BerZerKku/BVP_XXvX/readme.txt

Плата BVP.
Сделана в OrCAD 16.6.

>>> 04v5
Предназначена для работы в аппаратах Р400/Р400м/РЗСК/К400/ОПТИКА как со старыми панелями, так и с новыми.

Изменения:
Исправлена ошибка на схеме, сделана возможность управления МКУ.
Заменен конденсатор С8 на 0,01мкФ, для устранения "хрипов" во время сигнала вызова.
Добавлена возможность установки на плату УМ SSM2305.

Код ПП: 3.140.017
Код ПП в сборе: 2.140.175

Стэк:
18мкм  TOP 
1.5мм e=4.5 FR-4
18мкм  BOTTOM

>>> 04v4
Предназначена для работы в аппаратах Р400/Р400м/РЗСК/К400/ОПТИКА как со старыми панелями, так и с новыми.

Сигналы RxBSP и TxBSP поменяны друг с другом.
На схеме найдена ошибка, сигнал управления МКУ закорочен на землю - т.е. речи нет и не будет.
Работает с платой KVP_03v3.
При работе с платой KVP_03v2 не будет работать ЦС.

>>> 04v3
Добавлена цифровая ретрансляция.
На схеме найдена ошибка, перепутаны местами сигналы RxBSP и TxBSP. 
Не использовать.
Работает с платой KVP_03v3.
При работе с платой KVP_03v2 не будет работать ЦС.

>>> 04v2 - СЕРИЯ
Входы управления подключены к 24В вместо земли.
Изменена подтяжка на +5В сигнала речи для варианта К400 (в варианте с речью, 
подтяжка идет к +5ВА).
Неиспользуемые входы микросхемы DD2 подтянуты к земле через резистор 10кОм.
Сделана возможность использования платы для Р400.
Немного передвинуты линии сигнализаций в верхней части.

>>> 04v1
Первая версия платы. 
На схеме имеются ошибки. 
Не использовать.
