BerZerKku/BVP_XXvX/(list of files, cad)

Other CAD files:
doc/Плата BVP_04v5 2.140.175 (СБ).dwg
