BerZerKku/BVP_XXvX/doc/Плата BVP_04v5 2.140.175 (СБ).pdf

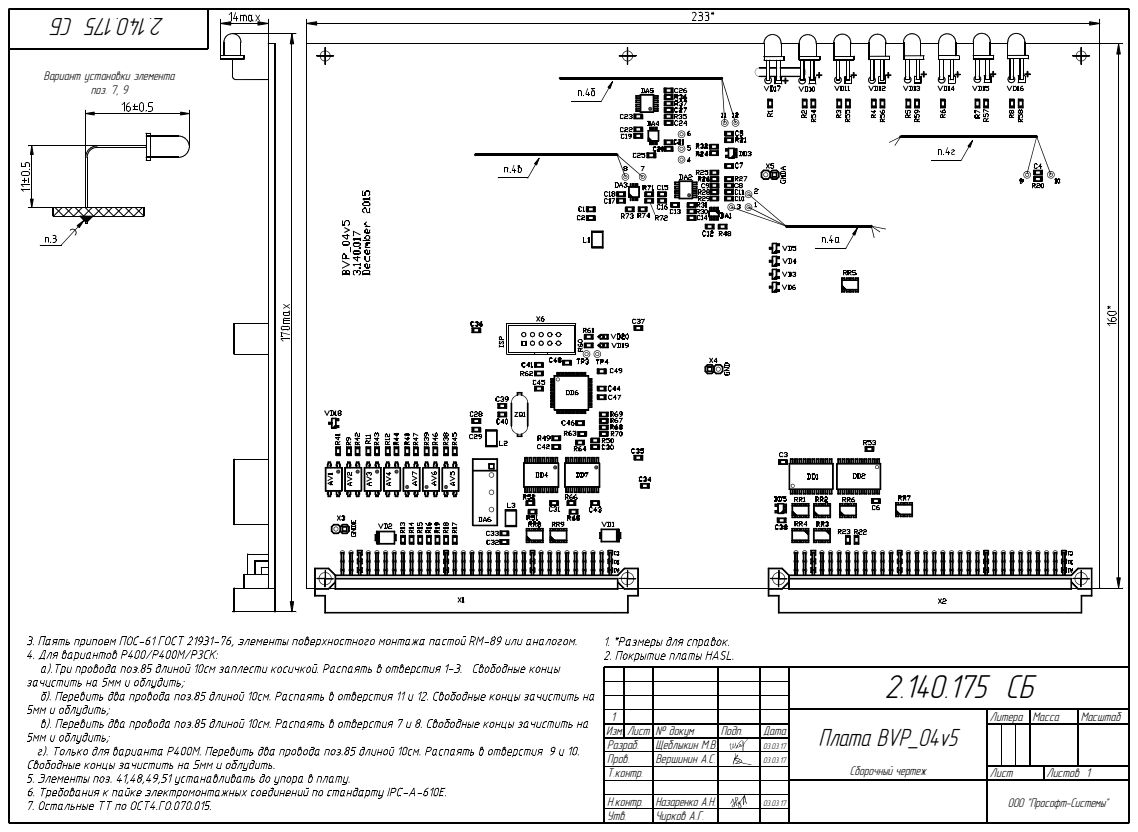
[picture p1: page 1]
Ëèñòîâ 1; Ìàññà; Ìàñøòàá; Ïîäï.; Äàòà; Óòâ.; Í.êîíòð.; Ò.êîíòð.; Ïðîâ.; Ðàçðàá.; Èçì. Ëèñò; ×èðêîâ À.Ã.; Íàçàðåíêî À.Í.; Âåðøèíèí À.Ñ.; Ùåáëûêèí Ì.Â.; № äîêóì; Ëèñò; Ëèòåðà; Ïëàòà BVP_04v5; ïîç. 7, 9

Âàðèàíò óñòàíîâêè ýëåìåíòà

Ñáîðî÷íûé ÷åðòåæ

ÎÎÎ "Ïðîñîôò-Ñèñòåìû"
