BerZerKku/BVP_XXvX/doc/Плата BVP_04v5 2.140.175 (Э3).pdf

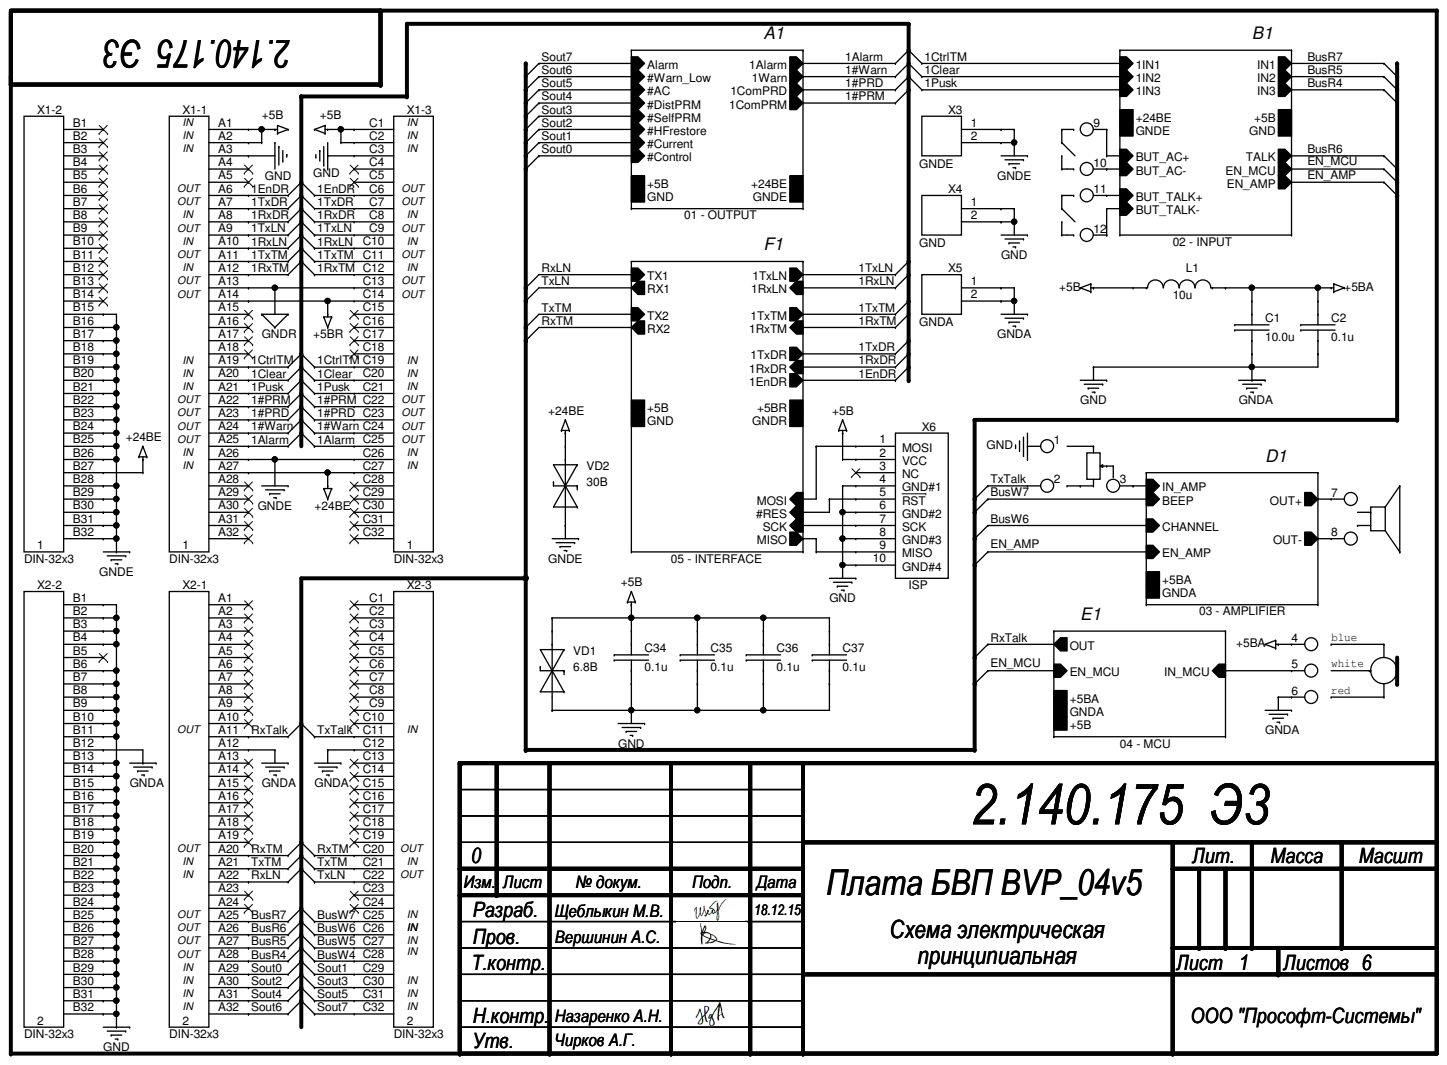
[picture p2: page 1]

0 | | | | | Плата БВП BVP_04v5 Плата БВП BVP_04v5 Плата БВП BVP_04v5 Схема электрическая Схема электрическая Схема электрическая | Лит. | Масса Масса Масса | Масшт Масшт Масшт
Изм. Изм. Изм. | Лист Лист Лист | № докум. № докум. № докум. | Подп. Подп. Подп. | Дата Дата Дата
Разраб. Разраб. Разраб. | | Щеблыкин М.В. Щеблыкин М.В. Щеблыкин М.В. | | 18.12.15 18.12.15 18.12.15
Пров. Пров. Пров. | | Вершинин А.С. Вершинин А.С. Вершинин А.С.
принципиальная Т.контр. принципиальная Т.контр. принципиальная Т.контр. | Лист Лист Лист 1 6 1 6 1 6 | Листов Листов Листов

Н.контр. Н.контр. Н.контр. | Назаренко А.Н. Назаренко А.Н. Назаренко А.Н.
Утв. Утв. Утв. | Чирков А.Г. Чирков А.Г. Чирков А.Г.

ООО "Прософт-Системы" ООО "Прософт-Системы" ООО "Прософт-Системы"

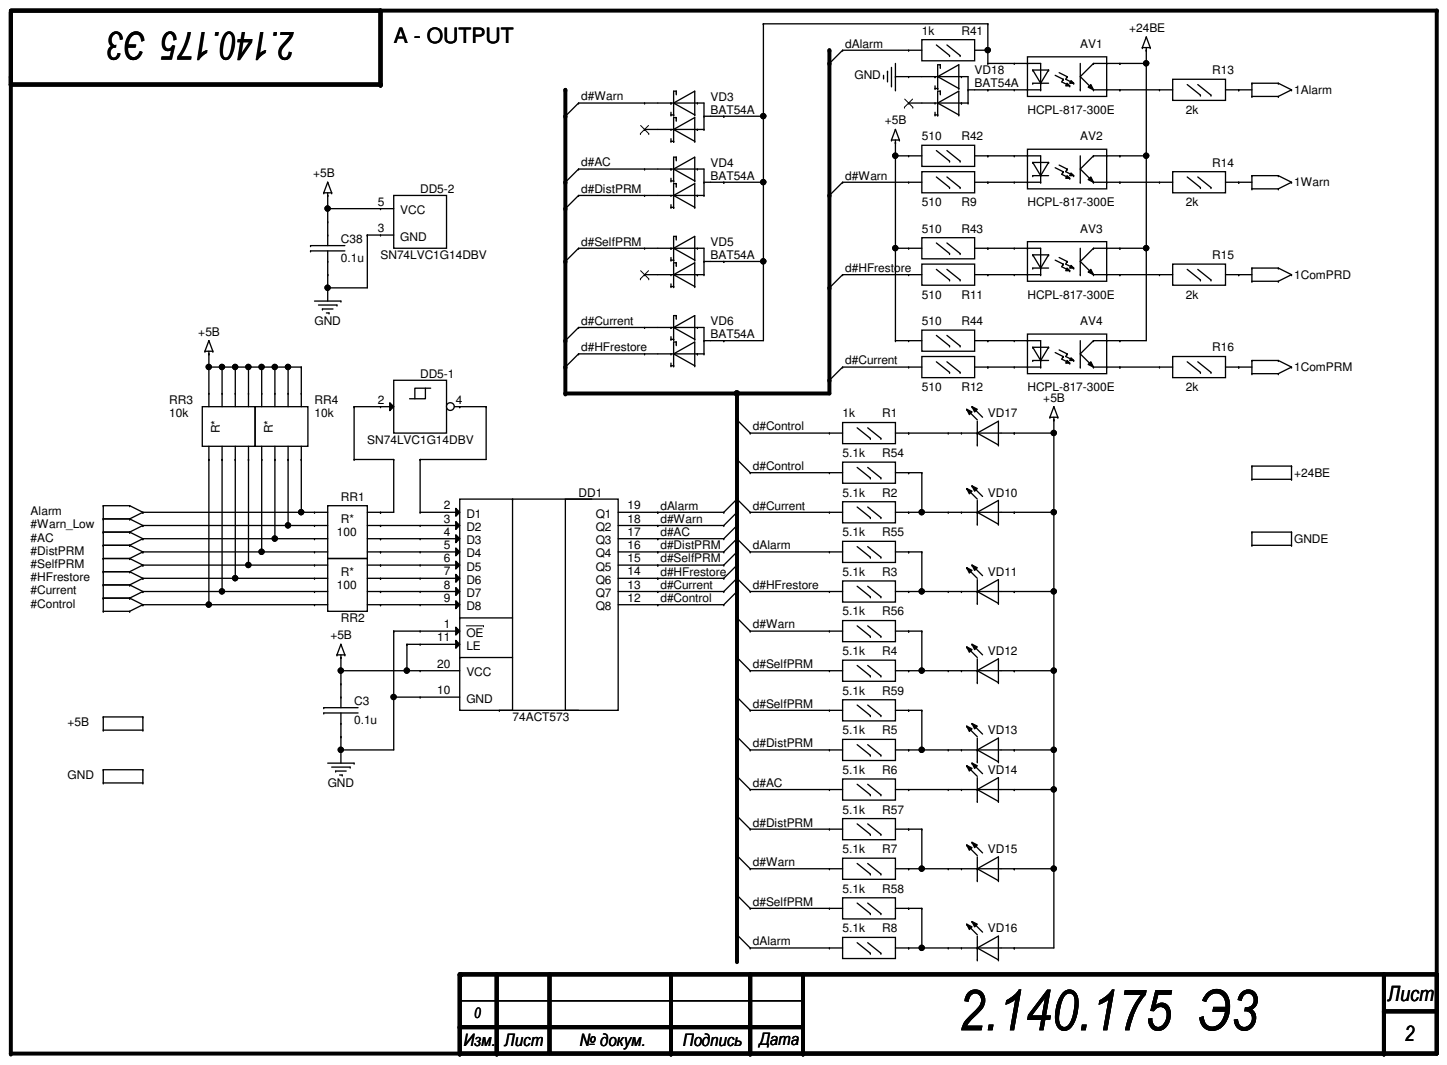
[picture p3: page 2]

Лист 2.140.175 Э3 Лист 2.140.175 Э3 Лист 2.140.175 Э3 2 ⁰ Изм. 2 ⁰ Изм. 2 ⁰

Лист | № докум. | Подпись | Дата

Изм. | Лист | № докум. | Подпись | Дата

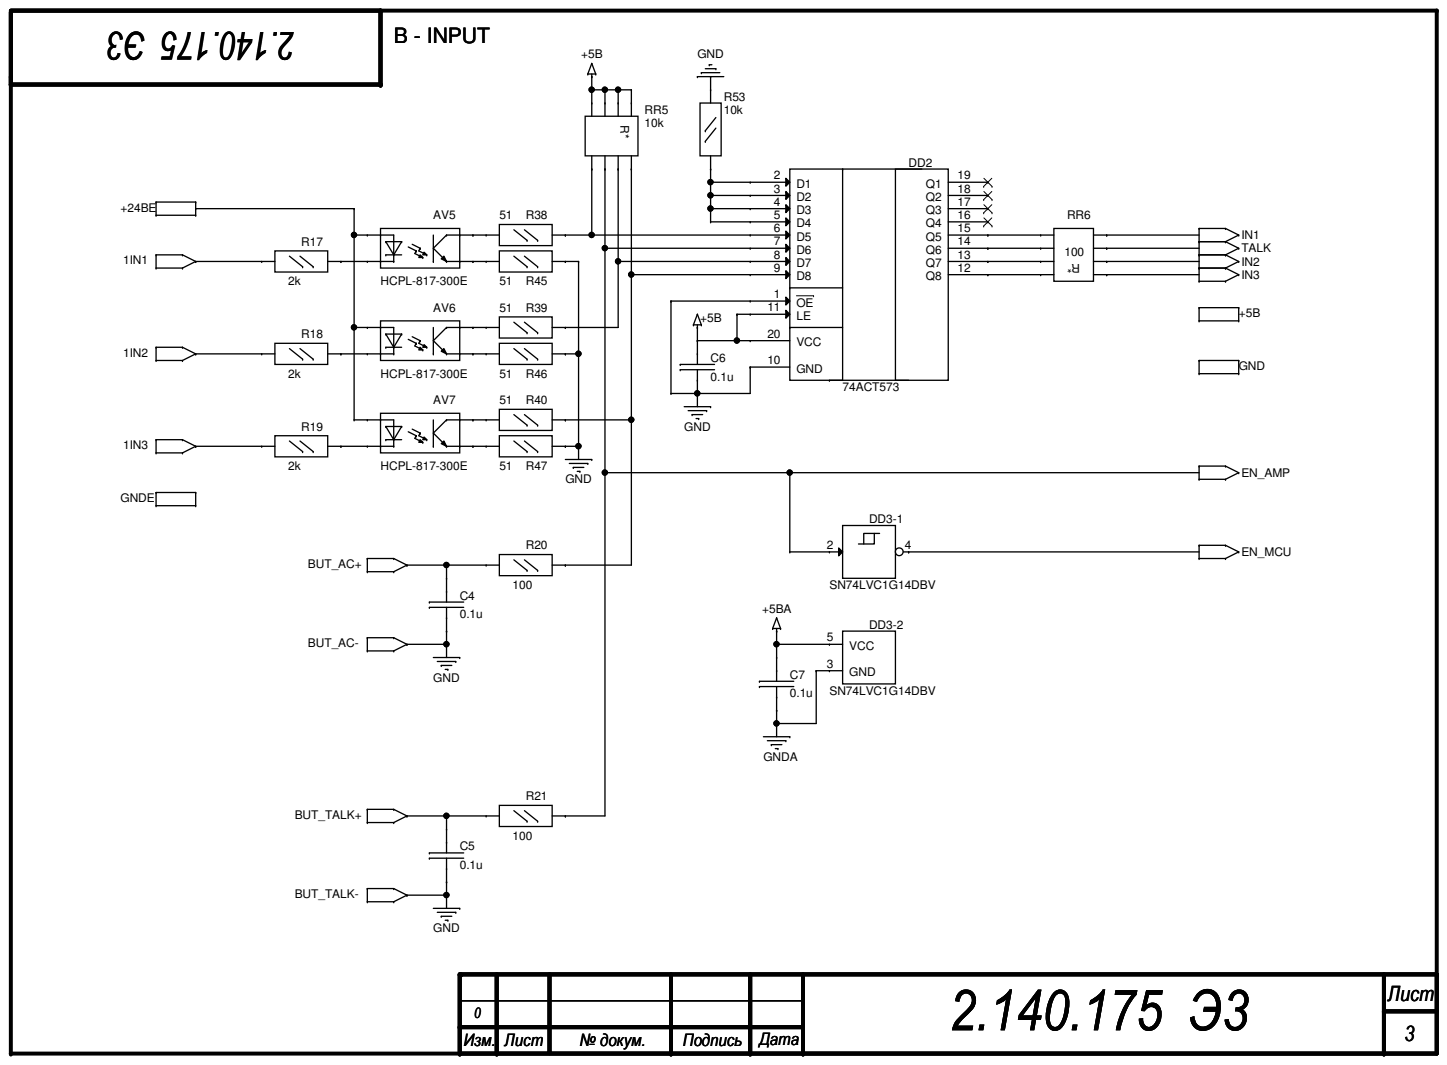
[picture p4: page 3]

Лист 2.140.175 Э3 Лист 2.140.175 Э3 Лист 2.140.175 Э3 3 ⁰ Изм. 3 ⁰ Изм. 3 ⁰

Лист | № докум. | Подпись | Дата

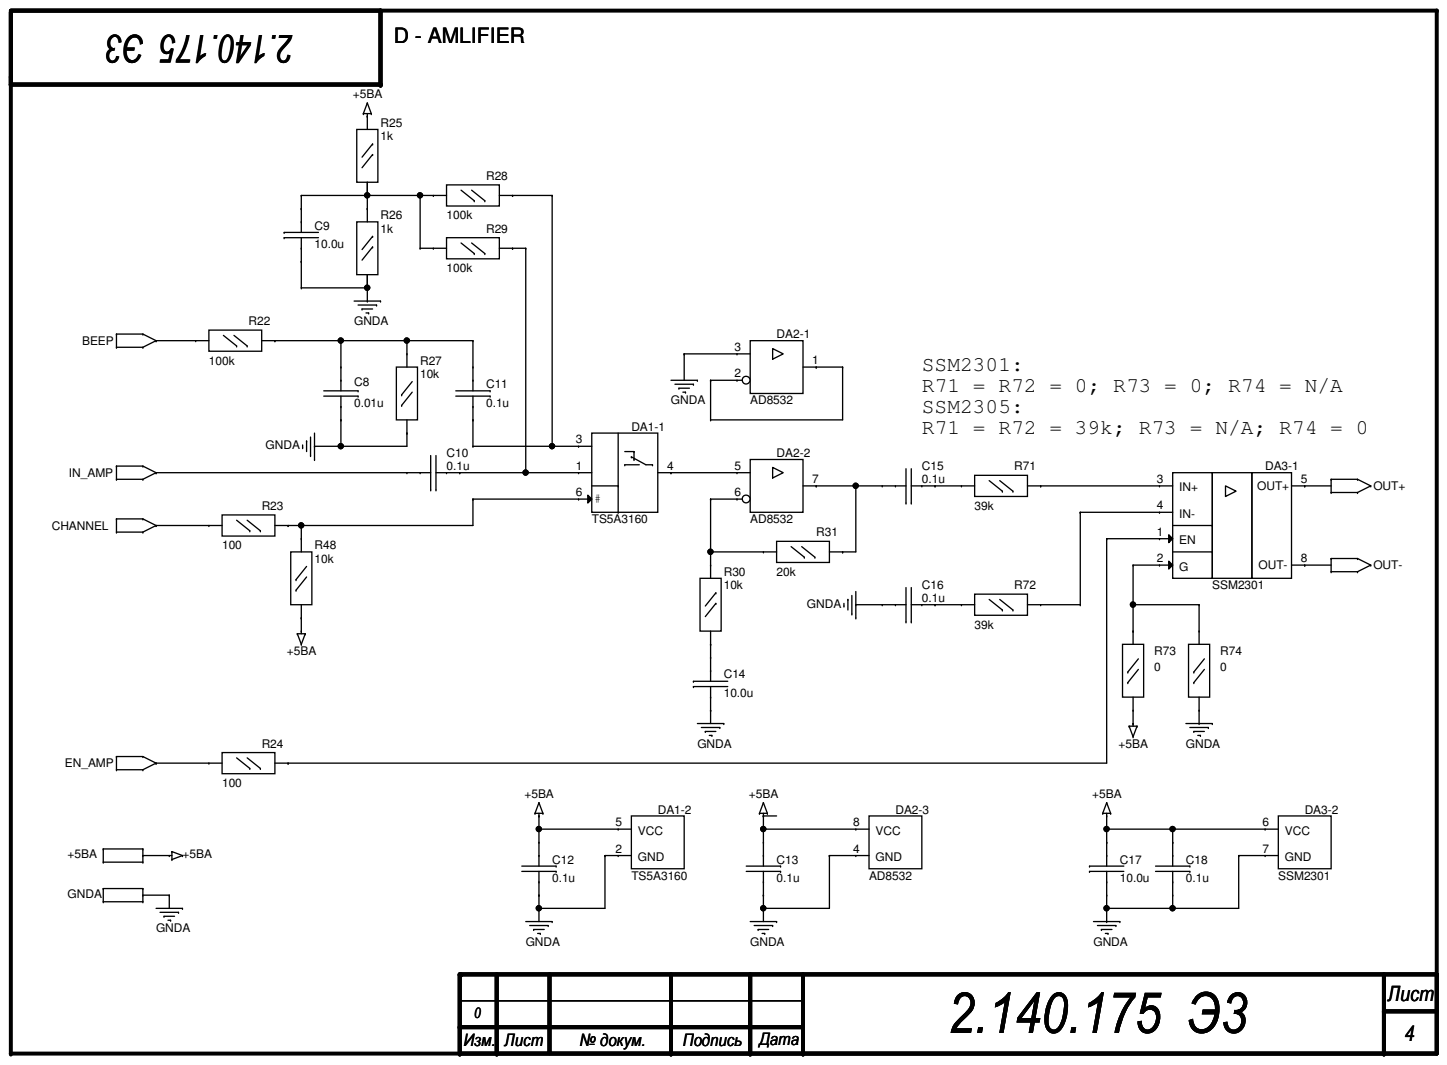
[picture p5: page 4]

Лист 2.140.175 Э3 Лист 2.140.175 Э3 Лист 2.140.175 Э3 4 ⁰ Изм. 4 ⁰ Изм. 4 ⁰

Лист | № докум. | Подпись | Дата

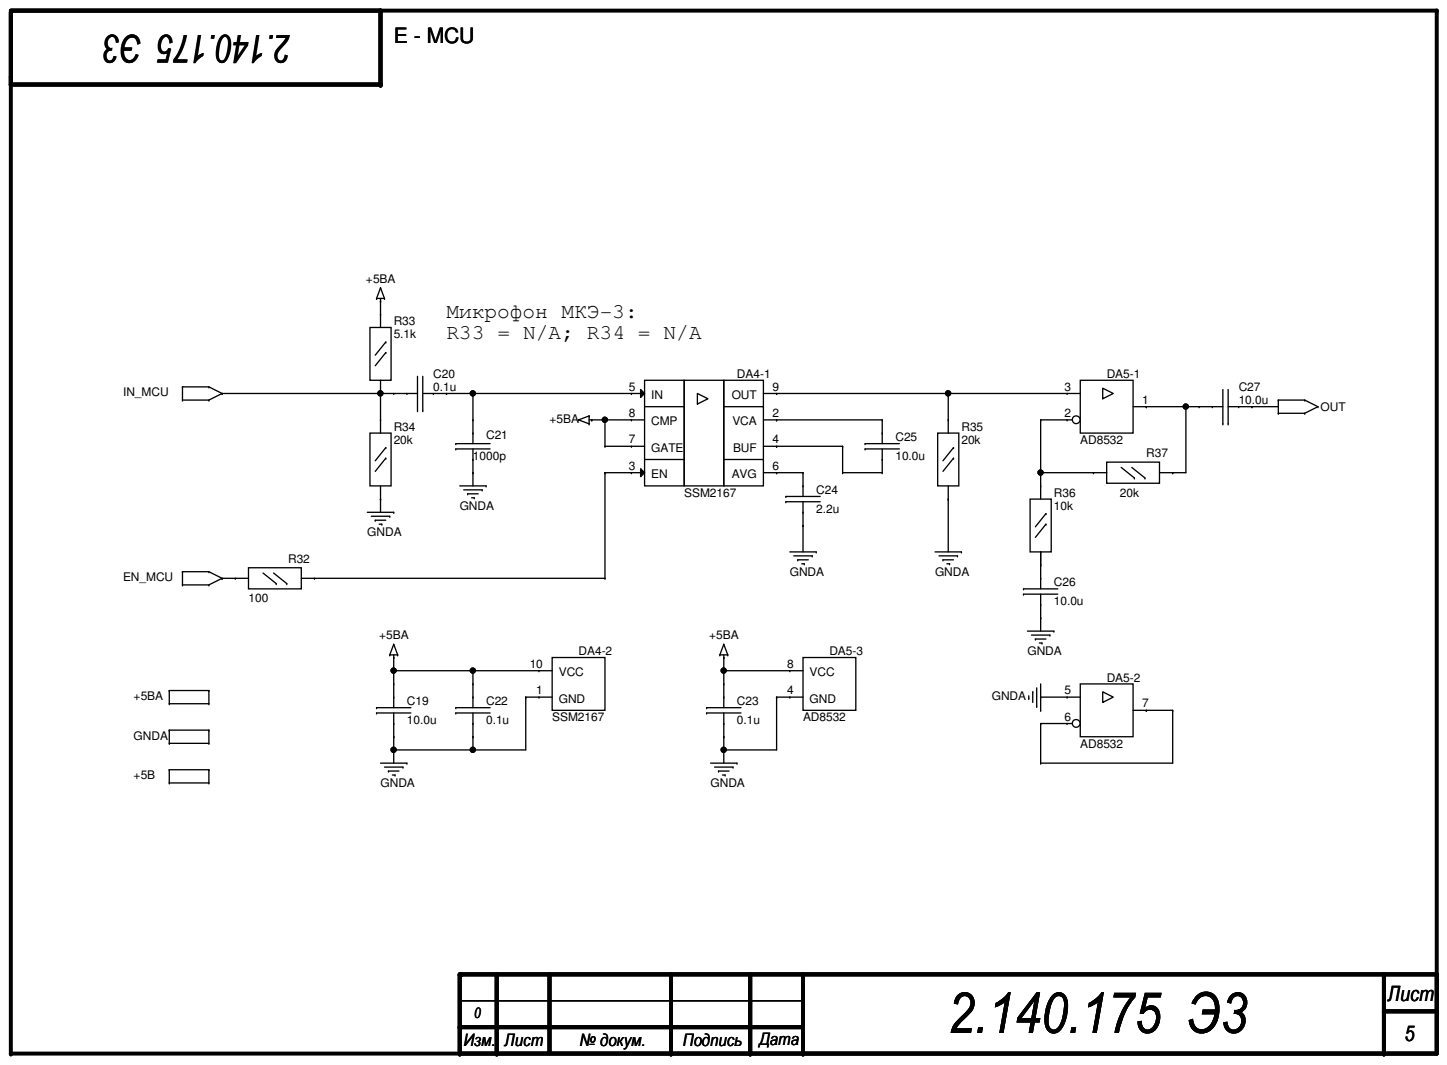
[picture p6: page 5]

Лист 2.140.175 Э3 Лист 2.140.175 Э3 Лист 2.140.175 Э3 5 ⁰ Изм. 5 ⁰ Изм. 5 ⁰

Лист | № докум. | Подпись | Дата

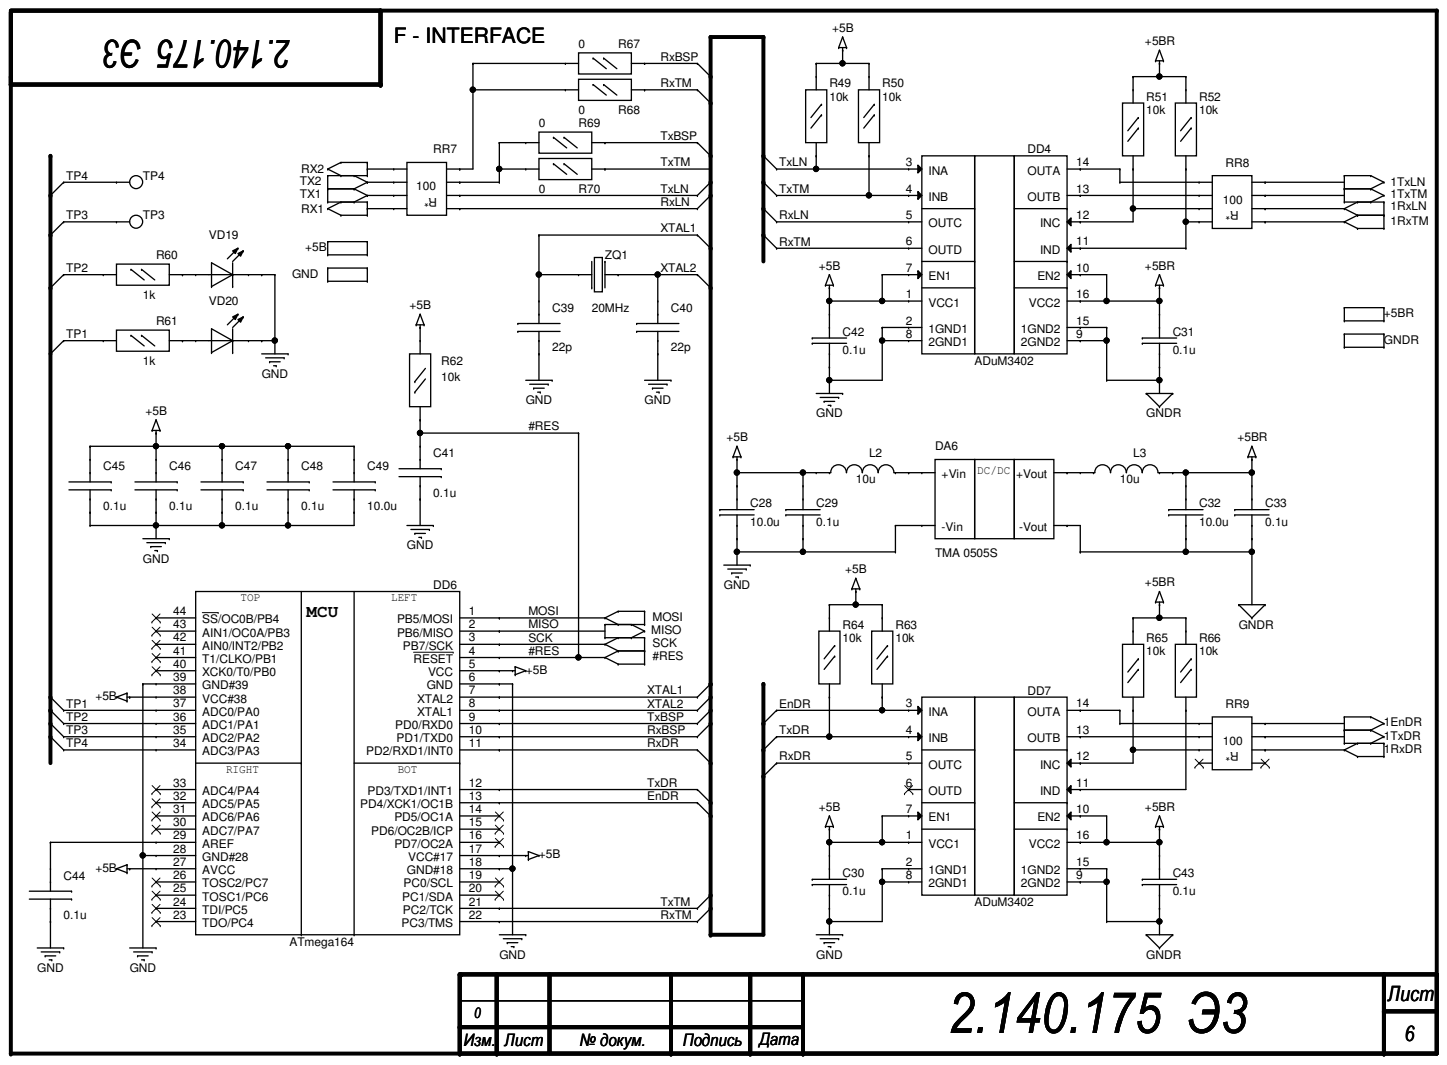
[picture p7: page 6]
