BerZerKku/BVP_XXvX/(list of files, drawings)

Other design files:
BVP_04V5.DSN
