BerZerKku/BVP_XXvX/(commit log)

2015-12-17 Вновь.
2015-12-17 Начата работа над платой BVP_04v5.
    [BVP_04V5.DSN, bvp_04v5.opj]
2015-12-18 Исправлена ошибка подключения управления МКУ. Заменен номинал C8 на 10нФ.
    [BVP_04V5.DSN, bvp_04v5.opj]
2015-12-18 Добавлена возможность установки УМ SSM2305.
    [BVP_04V5.DSN, BVP_04V5.brd, bvp_04v5.opj]
2015-12-21 Вылизано.
    [BVP_04V5.DSN, BVP_04V5.brd, bvp_04v5.opj]
2015-12-21 Плата отправлена в производство.
    [BVP_04V5.brd]
2016-02-20 На схеме приведены в порядок вариантные исполнения. Добавлена документация.
    [BVP_04V5.DSN, bvp_04v5.opj, Плата BVP_04v5 2.140.175 (СБ).dwg]
2016-02-20 Обновлен файл схемы.
    [BVP_04V5.DSN]
2016-02-29 В варианте РЗСК исправлено кол-во элементов поз.53 (0805 О Ом) с 2 на 3.
2016-04-22 Конденсатор C8 перекинуть из поз.17 в поз.18, а C21 из поз.18 в поз.17. В варианте РЗСК из поз.23 убран С49.
    [BVP_04V5.DSN]
2016-11-29 Добавлен гербер для пасты.
    [BVP_04V5.brd, art_param.txt, nc_param.txt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]
2017-03-03 СП rev.2 СБ rev.1 Исправлено изображение выводных светодиодов.
    [Плата BVP_04v5 2.140.175 (СБ).dwg]
2017-07-03 СП rev.3 Из варианта РЗСК убрана позиция 73 (резистор RR9 100 Ом 1206х4). Добавлен вариант Р400 ОПТИКА.
2020-04-22 Добавить параметры отверстий.
    В файле указаны диаметры отверстий после металлизации.
    [Параметры отверстий.xlsx]
